yuvalkuck/clearair/hardware/enclosure/sensor_tube.FCStd

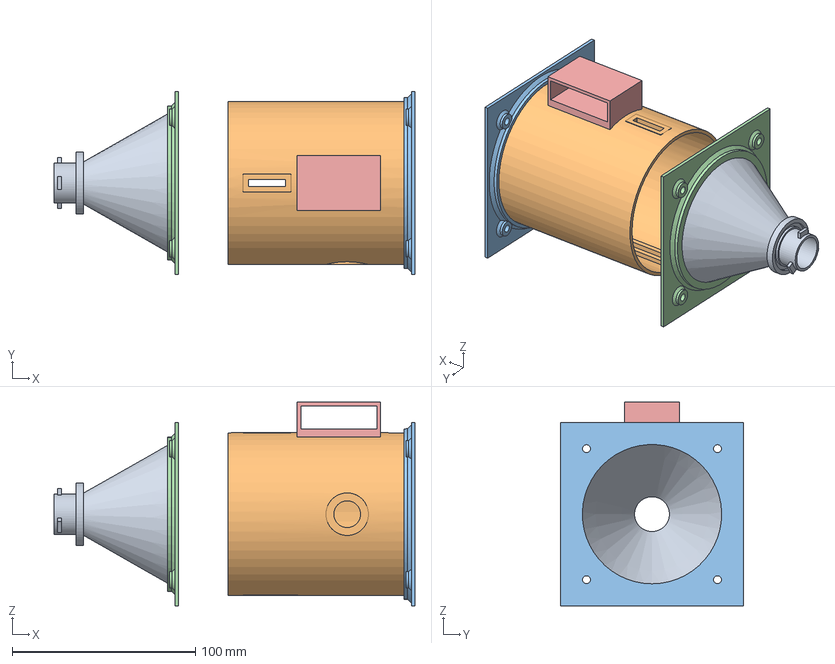
[picture p3: CAD file, 2026-10-23]
hardware/enclosure/sensor_tube.FCStd
197.0 x 100.0 x 111.1 mm
FilterAdapter
SensorTube
FanMount_rear
FanMount_front
SPS30_Holder
