yuvalkuck/clearair/hardware/WeAct-G474CE-Long/clearair.kicad_pcb

## KiCad design hardware/WeAct-G474CE-Long/clearair.kicad_pcb (2026-11-04)

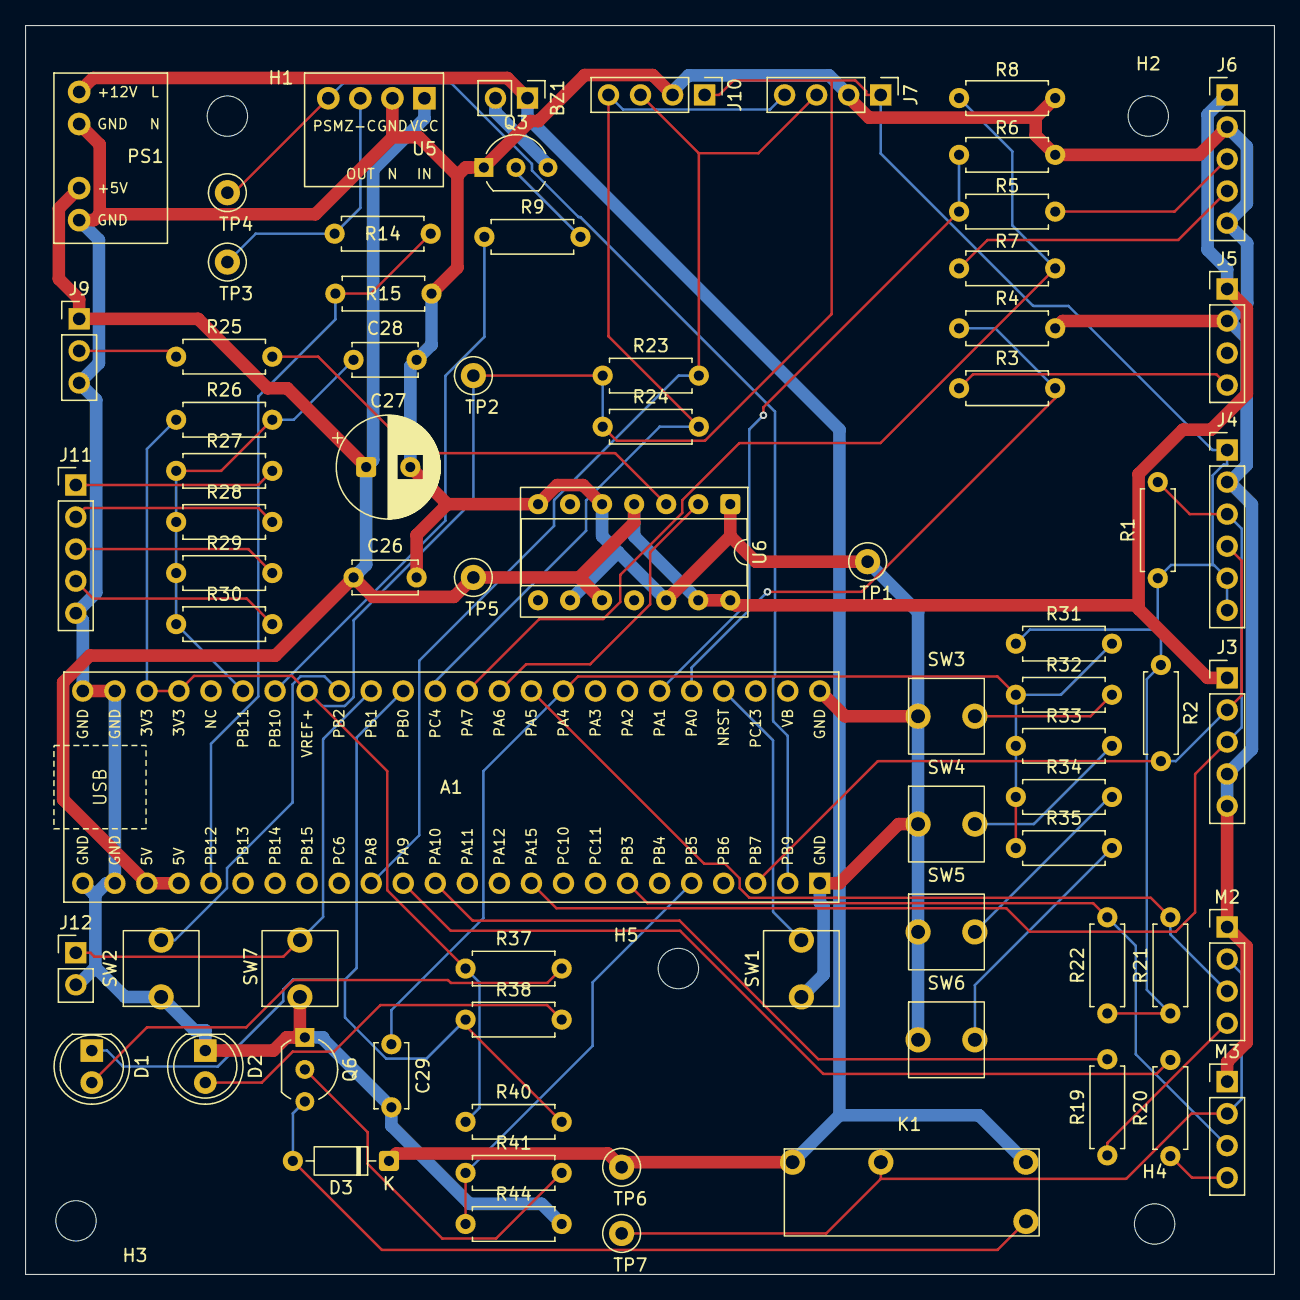
[picture p4: board clearair.kicad_pcb from above]

Board: 2 copper layers, 99.0 x 99.0 mm, 78 parts (0 on the bottom side), 49 nets.

Parts:
A1: WeAct STM32G474CEU6 Core Board (Long); WeAct_STM32G474CoreBoard_Long
BZ1: 12V buzzer; PinHeader_1x02_P2.54mm_Vertical
C26, C28, C29: 100nF; C_Disc_D5.0mm_W2.5mm_P5.00mm
C27: 220uF; CP_Radial_D8.0mm_P3.50mm
D1: GREEN; LED_D5.0mm
D2: RED; LED_D5.0mm
D3: 1N4148; D_DO-35_SOD27_P7.62mm_Horizontal
H1, H2, H3, H4, H5: M3; MountingHole_3.2mm_M3
J3: SPS30; PinHeader_1x05_P2.54mm_Vertical
J4: BME680; PinHeader_1x06_P2.54mm_Vertical
J5: MQ131; PinHeader_1x04_P2.54mm_Vertical
J6: MiCS-4514; PinHeader_1x05_P2.54mm_Vertical
J7: RTC PCF8563; PinHeader_1x04_P2.54mm_Vertical
J9: WS2812B LEDs; PinHeader_1x03_P2.54mm_Vertical
J10: Display I2C2; PinHeader_1x04_P2.54mm_Vertical
J11: Buttons (1-4 KEY1-4, 5 GND); PinHeader_1x05_P2.54mm_Vertical
J12: Standby ext; PinHeader_1x02_P2.54mm_Vertical
K1: ALDP112; Relay_Panasonic_ALDP112
M2: 80mm fan front; PinHeader_1x04_P2.54mm_Vertical
M3: 80mm fan rear; PinHeader_1x04_P2.54mm_Vertical
PS1: AC-DC PSUs 12V 2A + 5V 2A (DC out); PSU_DC_12V_5V_Inputs
Q3, Q6: 2N2222A; TO-92_Inline_Wide
R1, R2, R23, R24: 4k7; R_Axial_DIN0207_L6.3mm_D2.5mm_P7.62mm_Horizontal
R3, R5, R7, R14: 1k8; R_Axial_DIN0207_L6.3mm_D2.5mm_P7.62mm_Horizontal
R4, R6, R8, R15, R28, R33: 3k3; R_Axial_DIN0207_L6.3mm_D2.5mm_P7.62mm_Horizontal
R9, R19, R20, R27, R32, R41: 1k; R_Axial_DIN0207_L6.3mm_D2.5mm_P7.62mm_Horizontal
R21, R22, R26, R31, R44: 10k; R_Axial_DIN0207_L6.3mm_D2.5mm_P7.62mm_Horizontal
R25, R37, R38: 330; R_Axial_DIN0207_L6.3mm_D2.5mm_P7.62mm_Horizontal
R29, R34: 6k8; R_Axial_DIN0207_L6.3mm_D2.5mm_P7.62mm_Horizontal
R30, R35: 15k; R_Axial_DIN0207_L6.3mm_D2.5mm_P7.62mm_Horizontal
R40: 2k2; R_Axial_DIN0207_L6.3mm_D2.5mm_P7.62mm_Horizontal
SW1: RESET red; SW_Tactile_6x6x5_2pin
SW2: COLD_BOOT white; SW_Tactile_6x6x5_2pin
SW3: TEST1; SW_Tactile_6x6x5_2pin
SW4: TEST2; SW_Tactile_6x6x5_2pin
SW5: TEST3; SW_Tactile_6x6x5_2pin
SW6: TEST4; SW_Tactile_6x6x5_2pin
SW7: STANDBY; SW_Tactile_6x6x5_2pin
TP1: GND; TestPoint_Loop_D2.50mm_Drill1.0mm
TP2: +3V3; TestPoint_Loop_D2.50mm_Drill1.0mm
TP3: ZC_OUT; TestPoint_Loop_D2.50mm_Drill1.0mm
TP4: TRIAC_DIMMER; TestPoint_Loop_D2.50mm_Drill1.0mm
TP5: +5V; TestPoint_Loop_D2.50mm_Drill1.0mm
TP6: +12V; TestPoint_Loop_D2.50mm_Drill1.0mm
TP7: FAN_12V; TestPoint_Loop_D2.50mm_Drill1.0mm
U5: RobotDyn AC dimmer; RobotDyn_Dimmer_Logic
U6: 74AHCT125N; DIP-14_W7.62mm_Socket

Connections:
+3V3: A1.37 (VREF+), A1.47 (3V3), A1.48 (3V3), J4.1 (VCC), J4.5 (SDO), J4.6 (CS), J7.1, J10.1, R1.1, R2.1, R21.1, R22.1, R23.1, R24.1, R26.1, R31.1, R37.1, R40.1, TP2.1 (1_1)
+5V: A1.43 (VDD5V), A1.44 (VDD5V), C26.1, C27.1, J3.1, J5.1, J6.1, J9.1, PS1.4, TP5.1 (1_1), U5.1 (VCC), U6.4, U6.10, U6.13, U6.14 (VCC)
+12V: BZ1.1 (+), D3.1 (K), K1.14, K1.A1, PS1.3, TP6.1 (1_1)
/BOOT_MODE: A1.36 (PB2), SW2.2
/BUTTONS_ADC: A1.39 (PB11), C28.1, R26.2, R27.1, R28.1, R29.1, R30.1
/BUZZER_BASE: Q3.2 (B), R9.2
/BUZZER_NEG: BZ1.2 (-), Q3.3 (C)
/BUZZER_ON: A1.38 (PB10), R9.1
/FAN_12V: K1.13, M2.2, M3.2, TP7.1 (1_1)
/FAN_FRONT_PWM: A1.13 (PA10), R19.2
/FAN_FRONT_PWM_IN: M2.4, R19.1
/FAN_FRONT_TACH: A1.30 (PA5), M2.3, R21.2
/FAN_REAR_PWM: A1.14 (PA9), R20.2
/FAN_REAR_PWM_IN: M3.4, R20.1
/FAN_REAR_TACH: A1.7 (PB3), M3.3, R22.2
/FILTER_FAN_POWER: A1.5 (PB5), R41.1, R44.1
/FORCE_STATES_SW: A1.29 (PA4), C29.1, R31.2, R32.1, R33.1, R34.1, R35.1
/I2C_SCL: A1.10 (PA15), J3.3, J4.3 (SCL), R1.2
/I2C_SDA: A1.3 (PB7), J3.2, J4.4 (SDA), R2.2
/LED_DATA: A1.31 (PA6), U6.2
/MICS_CO1: A1.26 (PA1), R5.1, R6.1
/MICS_CO_OUT: J6.3, R5.2
/MICS_NO2: A1.32 (PA7), R7.2, R8.1
/MICS_NO2_OUT: J6.4, R7.1
/MQ131_ADC: A1.25 (PA0), R3.2, R4.1
/MQ131_OUT: J5.4, R3.1
/NRST: A1.24 (NRST), SW1.2
/RTC_SCL: A1.33 (PC4), J7.4, J10.4, R24.2
/RTC_SDA: A1.15 (PA8), J7.3, J10.3, R23.2
/STANDBY_LED: A1.34 (PB0), D1.1 (K), R38.1, R40.2
/STANDBY_SW: A1.35 (PB1), J12.1, SW7.2
/TRIAC_DIMMER: A1.2 (PB9), TP4.1 (1_1), U5.4 (PSM)
/ZC_INPUT: A1.20 (PB12), R14.1, R15.1
/ZC_OUT: R14.2, TP3.1 (1_1), U5.3 (Z-C)
GND: A1.1 (GND), A1.21 (GND), A1.41 (GND), A1.42 (GND), A1.45 (GND), A1.46 (GND), C26.2, C27.2, C28.2, C29.2, D2.1 (K), J3.4, J3.5, J4.2 (GND), J5.2, J6.2, J6.5, J7.2, J9.3, J10.2, J11.5, J12.2, M2.1, M3.1, PS1.5, Q3.1 (E), Q6.1 (E), R4.2, R6.2, R8.2, R15.2, R44.2, SW1.1, SW2.1, SW3.1, SW4.1, SW5.1, SW6.1, SW7.1, TP1.1 (1_1), U5.2 (GND), U6.1, U6.5, U6.7 (GND), U6.9, U6.12
unnamed: D1.2 (A), R37.2
unnamed: D2.2 (A), R38.2
unnamed: D3.2 (A), K1.A2, Q6.3 (C)
unnamed: J9.2, R25.1
unnamed: J11.1, R27.2
unnamed: J11.2, R28.2
unnamed: J11.3, R29.2
unnamed: J11.4, R30.2
unnamed: Q6.2 (B), R41.2
unnamed: R25.2, U6.3
unnamed: R32.2, SW3.2
unnamed: R33.2, SW4.2
unnamed: R34.2, SW5.2
unnamed: R35.2, SW6.2
