yuvalkuck/clearair/Core/Src/main.c

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
/* Includes ------------------------------------------------------------------*/
#include "main.h"
#include "cmsis_os.h"

/* USER CODE BEGIN Includes */
#include <stdio.h>

#include "event_message.h"
#include "queue.h"
/* USER CODE END Includes */

ADC_HandleTypeDef hadc1;
ADC_HandleTypeDef hadc2;
DMA_HandleTypeDef hdma_adc2;

I2C_HandleTypeDef hi2c1;
I2C_HandleTypeDef hi2c2;

TIM_HandleTypeDef htim1;
TIM_HandleTypeDef htim2;
TIM_HandleTypeDef htim3;
TIM_HandleTypeDef htim16;
DMA_HandleTypeDef hdma_tim16_ch1;

UART_HandleTypeDef huart2;

/* Definitions for defaultTask */
osThreadId_t defaultTaskHandle;
const osThreadAttr_t defaultTask_attributes = {
  .name = "defaultTask",
  .priority = (osPriority_t) osPriorityNormal,
  .stack_size = 256 * 4
};
/* Definitions for bmeTask */
osThreadId_t bmeTaskHandle;
const osThreadAttr_t bmeTask_attributes = {
  .name = "bmeTask",
  .priority = (osPriority_t) osPriorityNormal1,
  .stack_size = 512 * 4
};
/* Definitions for msgLoopTask */
osThreadId_t msgLoopTaskHandle;
const osThreadAttr_t msgLoopTask_attributes = {
  .name = "msgLoopTask",
  .priority = (osPriority_t) osPriorityNormal,
  .stack_size = 256 * 4
};
/* Definitions for co1no2Task */
osThreadId_t co1no2TaskHandle;
const osThreadAttr_t co1no2Task_attributes = {
  .name = "co1no2Task",
  .priority = (osPriority_t) osPriorityNormal1,
  .stack_size = 256 * 4
};
/* Definitions for particleTask */
osThreadId_t particleTaskHandle;
const osThreadAttr_t particleTask_attributes = {
  .name = "particleTask",
  .priority = (osPriority_t) osPriorityNormal,
  .stack_size = 512 * 4
};
/* Definitions for o3Task */
osThreadId_t o3TaskHandle;
const osThreadAttr_t o3Task_attributes = {
  .name = "o3Task",
  .priority = (osPriority_t) osPriorityNormal,
  .stack_size = 512 * 4
};
/* Definitions for rtcTask */
osThreadId_t rtcTaskHandle;
const osThreadAttr_t rtcTask_attributes = {
  .name = "rtcTask",
  .priority = (osPriority_t) osPriorityLow,
  .stack_size = 256 * 4
};
/* Definitions for SensorEvents */
osMessageQueueId_t SensorEventsHandle;
const osMessageQueueAttr_t SensorEvents_attributes = {
  .name = "SensorEvents"
};
/* USER CODE BEGIN PV */
extern QueueHandle_t sensorsQueue;
/* USER CODE END PV */

void SystemClock_Config(void);
static void MX_GPIO_Init(void);
static void MX_DMA_Init(void);
static void MX_ADC1_Init(void);
static void MX_ADC2_Init(void);
static void MX_I2C1_Init(void);
static void MX_TIM3_Init(void);
static void MX_USART2_UART_Init(void);
static void MX_TIM1_Init(void);
static void MX_TIM2_Init(void);
static void MX_I2C2_Init(void);
static void MX_TIM16_Init(void);
void StartDefaultTask(void *argument);
extern void bmeTaskHandler(void *argument);
extern void mainSensorsMsgLoop(void *argument);
extern void co1no2TaskHandler(void *argument);
extern void particleTaskHandler(void *argument);
extern void o3TaskHandler(void *argument);
extern void rtcTaskHandler(void *argument);

/* USER CODE BEGIN PFP */
extern void appStartDefaultTask(void *argument);

#ifdef __GNUC__
#define PUTCHAR_PROTOTYPE int __io_putchar(int ch)
#else
#define PUTCHAR_PROTOTYPE int fputc(int ch, FILE *f)
#endif

PUTCHAR_PROTOTYPE
{
  // Replace huart1 with your actual UART instance (e.g., huart2 or huart3)
  HAL_UART_Transmit(&huart2, (uint8_t *)&ch, 1, HAL_MAX_DELAY);
  return ch;
}
/* USER CODE END PFP */

/**
  * @brief  The application entry point.
  * @retval int
  */
int main(void)
{

  /* USER CODE BEGIN 1 */
  SystemInit();
  /* USER CODE END 1 */

  /* MCU Configuration--------------------------------------------------------*/

  /* Reset of all peripherals, Initializes the Flash interface and the Systick. */
  HAL_Init();

  /* Configure the system clock */
  SystemClock_Config();

  /* Initialize all configured peripherals */
  MX_GPIO_Init();
  MX_DMA_Init();
  MX_ADC1_Init();
  MX_ADC2_Init();
  MX_I2C1_Init();
  MX_TIM3_Init();
  MX_USART2_UART_Init();
  MX_TIM1_Init();
  MX_TIM2_Init();
  MX_I2C2_Init();
  MX_TIM16_Init();
  /* Init scheduler */
  osKernelInitialize();

  /* USER CODE BEGIN RTOS_MUTEX */
  /* add mutexes, ... */
  /* USER CODE END RTOS_MUTEX */

  /* USER CODE BEGIN RTOS_SEMAPHORES */
  /* add semaphores, ... */
  /* USER CODE END RTOS_SEMAPHORES */

  /* USER CODE BEGIN RTOS_TIMERS */
  /* start timers, add new ones, ... */
  /* USER CODE END RTOS_TIMERS */

  /* Create the queue(s) */
  /* creation of SensorEvents */
  SensorEventsHandle = osMessageQueueNew (42, sizeof(struct CommonMessage), &SensorEvents_attributes);

  /* USER CODE BEGIN RTOS_QUEUES */
  /* add queues, ... */
  /* USER CODE END RTOS_QUEUES */

  /* Create the thread(s) */
  /* creation of defaultTask */
  defaultTaskHandle = osThreadNew(StartDefaultTask, NULL, &defaultTask_attributes);

  /* creation of bmeTask */
  bmeTaskHandle = osThreadNew(bmeTaskHandler, NULL, &bmeTask_attributes);

  /* creation of msgLoopTask */
  msgLoopTaskHandle = osThreadNew(mainSensorsMsgLoop, NULL, &msgLoopTask_attributes);

  /* creation of co1no2Task */
  co1no2TaskHandle = osThreadNew(co1no2TaskHandler, NULL, &co1no2Task_attributes);

  /* creation of particleTask */
  particleTaskHandle = osThreadNew(particleTaskHandler, NULL, &particleTask_attributes);

  /* creation of o3Task */
  o3TaskHandle = osThreadNew(o3TaskHandler, NULL, &o3Task_attributes);

  /* creation of rtcTask */
  rtcTaskHandle = osThreadNew(rtcTaskHandler, NULL, &rtcTask_attributes);

  /* USER CODE BEGIN RTOS_THREADS */
  /* add threads, ... */
  /* USER CODE END RTOS_THREADS */

  /* USER CODE BEGIN RTOS_EVENTS */
  /* add events, ... */
  /* USER CODE END RTOS_EVENTS */

  /* Start scheduler */
  osKernelStart();

  /* We should never get here as control is now taken by the scheduler */

  /* Infinite loop */
  /* USER CODE BEGIN WHILE */
  while (1)
  {

    /* USER CODE END WHILE */

    /* USER CODE BEGIN 3 */
  }
  /* USER CODE END 3 */
}

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
/* USER CODE BEGIN Header_StartDefaultTask */
/**
  * @brief  Function implementing the defaultTask thread.
  * @param  argument: Not used
  * @retval None
  */
/* USER CODE END Header_StartDefaultTask */
void StartDefaultTask(void *argument)
{
  /* USER CODE BEGIN 5 */
  appStartDefaultTask(argument);
  /* Infinite loop */
  for(;;)
  {
    osDelay(1);
  }
  /* USER CODE END 5 */
}

/**
  * @brief  Period elapsed callback in non blocking mode
  * @note   This function is called  when TIM6 interrupt took place, inside
  * HAL_TIM_IRQHandler(). It makes a direct call to HAL_IncTick() to increment
  * a global variable "uwTick" used as application time base.
  * @param  htim : TIM handle
  * @retval None
  */
void HAL_TIM_PeriodElapsedCallback(TIM_HandleTypeDef *htim)
{
  if (htim->Instance == TIM6)
  {
    HAL_IncTick();
  }
}

/**
  * @brief  This function is executed in case of error occurrence.
  * @retval None
  */
void Error_Handler(void)
{
  /* USER CODE BEGIN Error_Handler_Debug */
  /* User can add his own implementation to report the HAL error return state */
  __disable_irq();
  while (1)
  {
  }
  /* USER CODE END Error_Handler_Debug */
}
#ifdef USE_FULL_ASSERT
/**
  * @brief  Reports the name of the source file and the source line number
  *         where the assert_param error has occurred.
  * @param  file: pointer to the source file name
  * @param  line: assert_param error line source number
  * @retval None
  */
void assert_failed(uint8_t *file, uint32_t line)
{
  /* USER CODE BEGIN 6 */
  /* User can add his own implementation to report the file name and line number,
     ex: printf("Wrong parameters value: file %s on line %d\r\n", file, line) */
  /* USER CODE END 6 */
}
#endif /* USE_FULL_ASSERT */
