yuvalkuck/clearair/clear-air.ioc

Mcu.UserName=STM32G474CEUx
PA0.GPIO_Label=MQ131_ADC
PA0.Signal=ADC1_IN1
PA1.GPIO_Label=MICS_CO1
PA1.Signal=ADC2_IN2
PA10.GPIO_Label=FAN_FRONT_PWM
PA10.Signal=S_TIM1_CH3
PA13.Signal=SYS_JTMS-SWDIO
PA14.Signal=SYS_JTCK-SWCLK
PA15.GPIO_Label=I2C_SCL
PA15.Signal=I2C1_SCL
PA2.Signal=USART2_TX
PA3.Signal=USART2_RX
PA4.GPIO_Label=FORCE_STATES_SW
PA4.Signal=ADC2_IN17
PA5.GPIO_Label=FAN_FRONT_TACH
PA5.Signal=S_TIM2_CH1
PA6.GPIO_Label=LED_DATA
PA6.Signal=S_TIM16_CH1
PA7.GPIO_Label=MICS_NO2
PA7.Signal=ADC2_IN4
PA8.GPIO_Label=RTC_SDA
PA8.Signal=I2C2_SDA
PA9.GPIO_Label=FAN_REAR_PWM
PA9.Signal=S_TIM1_CH2
PB0.GPIO_Label=STANDBY_LED
PB0.Signal=GPIO_Output
PB1.GPIO_Label=STANDBY_SW
PB1.Signal=GPIO_Input
PB10.GPIO_Label=BUZZER_ON
PB10.Signal=GPIO_Output
PB11.GPIO_Label=BUTTONS_ADC
PB11.Signal=ADC2_IN14
PB12.GPIO_Label=ZC_INPUT
PB12.Signal=GPXTI12
PB2.GPIO_Label=BOOT_MODE
PB2.Signal=GPIO_Input
PB3.GPIO_Label=FAN_REAR_TACH
PB3.Signal=S_TIM2_CH2
PB5.GPIO_Label=FILTER_FAN_POWER
PB5.Signal=GPIO_Output
PB7.GPIO_Label=I2C_SDA
PB7.Signal=I2C1_SDA
PB9.GPIO_Label=TRIAC_DIMMER
PB9.Signal=GPIO_Output
PC4.GPIO_Label=RTC_SCL
PC4.Signal=I2C2_SCL
PC6.GPIO_Label=LED_BOARD
PC6.Signal=GPIO_Output
PF0-OSC_IN.Signal=RCC_OSC_IN
PF1-OSC_OUT.Signal=RCC_OSC_OUT
