yuvalkuck/clearair/Core/Inc/main.h

#define MQ131_ADC_Pin GPIO_PIN_0
#define MQ131_ADC_GPIO_Port GPIOA
#define MICS_CO1_Pin GPIO_PIN_1
#define MICS_CO1_GPIO_Port GPIOA
#define FORCE_STATES_SW_Pin GPIO_PIN_4
#define FORCE_STATES_SW_GPIO_Port GPIOA
#define FAN_FRONT_TACH_Pin GPIO_PIN_5
#define FAN_FRONT_TACH_GPIO_Port GPIOA
#define LED_DATA_Pin GPIO_PIN_6
#define LED_DATA_GPIO_Port GPIOA
#define MICS_NO2_Pin GPIO_PIN_7
#define MICS_NO2_GPIO_Port GPIOA
#define RTC_SCL_Pin GPIO_PIN_4
#define RTC_SCL_GPIO_Port GPIOC
#define STANDBY_LED_Pin GPIO_PIN_0
#define STANDBY_LED_GPIO_Port GPIOB
#define STANDBY_SW_Pin GPIO_PIN_1
#define STANDBY_SW_GPIO_Port GPIOB
#define BOOT_MODE_Pin GPIO_PIN_2
#define BOOT_MODE_GPIO_Port GPIOB
#define BUZZER_ON_Pin GPIO_PIN_10
#define BUZZER_ON_GPIO_Port GPIOB
#define BUTTONS_ADC_Pin GPIO_PIN_11
#define BUTTONS_ADC_GPIO_Port GPIOB
#define ZC_INPUT_Pin GPIO_PIN_12
#define ZC_INPUT_GPIO_Port GPIOB
#define ZC_INPUT_EXTI_IRQn EXTI15_10_IRQn
#define LED_BOARD_Pin GPIO_PIN_6
#define LED_BOARD_GPIO_Port GPIOC
#define RTC_SDA_Pin GPIO_PIN_8
#define RTC_SDA_GPIO_Port GPIOA
#define FAN_REAR_PWM_Pin GPIO_PIN_9
#define FAN_REAR_PWM_GPIO_Port GPIOA
#define FAN_FRONT_PWM_Pin GPIO_PIN_10
#define FAN_FRONT_PWM_GPIO_Port GPIOA
#define I2C_SCL_Pin GPIO_PIN_15
#define I2C_SCL_GPIO_Port GPIOA
#define FAN_REAR_TACH_Pin GPIO_PIN_3
#define FAN_REAR_TACH_GPIO_Port GPIOB
#define FILTER_FAN_POWER_Pin GPIO_PIN_5
#define FILTER_FAN_POWER_GPIO_Port GPIOB
#define I2C_SDA_Pin GPIO_PIN_7
#define I2C_SDA_GPIO_Port GPIOB
#define TRIAC_DIMMER_Pin GPIO_PIN_9
#define TRIAC_DIMMER_GPIO_Port GPIOB
#define DETECTION_SLEEP_LOOP_LIMIT 50000 // 5sec of sleep
