yuvalkuck/clearair/Core/Inc/cpp_main.h

//
// Created by uv on 20/07/2026.
//

#ifndef CLEARAIR_CPP_MAIN_H
#define CLEARAIR_CPP_MAIN_H

#ifdef __cplusplus
#include "event_message.h"
extern "C" {
#endif
#include "main.h"

#ifdef __cplusplus
}
#endif


#endif //CLEARAIR_CPP_MAIN_H
