yuvalkuck/clearair/Core/Inc/app_main.h

//
// Created by uv on 20/07/2026.
//

#ifndef CLEARAIR_APP_MAIN_H
#define CLEARAIR_APP_MAIN_H

#ifdef __cplusplus
#include "event_message.h"
extern "C" {
#endif
#include "main.h"
int app_main(void);
#ifdef __cplusplus
}
#endif


#endif //CLEARAIR_APP_MAIN_H
