yuvalkuck/clearair/app/bme68x/src/task_bme680.cpp

//
// Created by uv on 22/07/2026.
//

#include "stm32f4xx.h"
#include "bridge_bme680.h"
#include "task_bme680.h"
#include "cmsis_os.h"
#include "bme68x.h"
#include "bsec_interface.h"
#include "bsec_iaq.h"
#include "event_message.h"
#include "queue.h"
extern osThreadId_t bmeSensorTaskHandle;
static uint8_t work_buffer[BSEC_MAX_WORKBUFFER_SIZE];
static bme68x_dev commBridgeCfg = {0};
static constexpr uint32_t BSEC_TASK_MAX_WAIT_MS     = 2000; // BME68x max heater dur
#define BSEC_REQUESTED_OUTPUTS 6

static auto applyBsecSensorSettings(const bsec_bme_settings_t& settings) {
    bme68x_conf conf{};
    bme68x_heatr_conf heatr_conf{};

    auto rc = bme68x_get_conf(&conf, &commBridgeCfg);
    if (rc != BME68X_OK) { return rc; }

    conf.os_hum = settings.humidity_oversampling;
    conf.os_temp = settings.temperature_oversampling;
    conf.os_pres = settings.pressure_oversampling;
    rc = bme68x_set_conf(&conf, &commBridgeCfg);
    if (rc != BME68X_OK) { return rc; }

    heatr_conf.enable = BME68X_ENABLE;
    heatr_conf.heatr_temp = settings.heater_temperature;
    heatr_conf.heatr_dur = settings.heater_duration;
    rc = bme68x_set_heatr_conf(BME68X_FORCED_MODE, &heatr_conf, &commBridgeCfg);
    if (rc != BME68X_OK) { return rc; }

    rc = bme68x_set_op_mode(BME68X_FORCED_MODE, &commBridgeCfg);
    return rc;
}
void TaskBme680::run() {
    osThreadResume(bmeSensorTaskHandle);
}

bool TaskBme680::configure(osMessageQueueId_t output_queue, I2C_HandleTypeDef* hi2c, uint8_t i2c_addr8) {
    msgQueue_ = (QueueHandle_t)output_queue;
    auto rc = initBridgeBME68x(hi2c, commBridgeCfg, i2c_addr8);
    if (rc != BME68X_OK) {
        return false;
    }
    rc = bsec_init();
    if (rc != BSEC_OK) {
        return false;
    }

    rc = bsec_set_configuration(bsec_config_iaq, sizeof(bsec_config_iaq),
                                work_buffer, sizeof(work_buffer));
    if (rc != BSEC_OK) {
        return false;
    }

    bsec_sensor_configuration_t requestedOutputs[BSEC_REQUESTED_OUTPUTS];
    uint8_t nRequested = 0;

    requestedOutputs[nRequested++] = {BSEC_SAMPLE_RATE_LP, BSEC_OUTPUT_IAQ};
    requestedOutputs[nRequested++] = {BSEC_SAMPLE_RATE_LP, BSEC_OUTPUT_STATIC_IAQ};
    requestedOutputs[nRequested++] = {BSEC_SAMPLE_RATE_LP, BSEC_OUTPUT_CO2_EQUIVALENT};
    requestedOutputs[nRequested++] = {BSEC_SAMPLE_RATE_LP, BSEC_OUTPUT_BREATH_VOC_EQUIVALENT};
    requestedOutputs[nRequested++] = {BSEC_SAMPLE_RATE_LP, BSEC_OUTPUT_RAW_TEMPERATURE};
    requestedOutputs[nRequested++] = {BSEC_SAMPLE_RATE_LP, BSEC_OUTPUT_RAW_HUMIDITY};

    bsec_sensor_configuration_t requiredSensorSettings[BSEC_MAX_PHYSICAL_SENSOR];
    uint8_t nRequired = BSEC_MAX_PHYSICAL_SENSOR;

    rc = bsec_update_subscription(requestedOutputs, nRequested,
                                  requiredSensorSettings, &nRequired);

    return (rc == BSEC_OK);
}

static uint32_t getTimestampMs() {
    // Convert ticks to milliseconds safely based on your RTOS clock rate
    // (If configTICK_RATE_HZ is 1000, ms directly equals ticks)
    return osKernelGetTickCount() * 1000 / osKernelGetTickFreq();
}

static int64_t getTimestampNs() {
    // Convert milliseconds to nanoseconds
    return 1000000ULL * getTimestampMs();
}

void TaskBme680::readAndSendToQueue(const bsec_bme_settings_t& s, int64_t timestamp_ns) {
    bme68x_data data;
    uint8_t n_data = 0;
    if (bme68x_get_data(BME68X_FORCED_MODE, &data, &n_data, &commBridgeCfg) != BME68X_OK || n_data == 0)
        return;

    bsec_input_t inputs[BSEC_MAX_PHYSICAL_SENSOR];
    uint8_t n_inputs = 0;

    if (s.process_data & BSEC_PROCESS_TEMPERATURE) {
        inputs[n_inputs].sensor_id = BSEC_INPUT_TEMPERATURE;
        inputs[n_inputs].signal = data.temperature;
        inputs[n_inputs].time_stamp = timestamp_ns;
        n_inputs++;
    }
    if (s.process_data & BSEC_PROCESS_HUMIDITY) {
        inputs[n_inputs].sensor_id = BSEC_INPUT_HUMIDITY;
        inputs[n_inputs].signal = data.humidity;
        inputs[n_inputs].time_stamp = timestamp_ns;
        n_inputs++;
    }
    if (s.process_data & BSEC_PROCESS_PRESSURE) {
        inputs[n_inputs].sensor_id = BSEC_INPUT_PRESSURE;
        inputs[n_inputs].signal = data.pressure;
        inputs[n_inputs].time_stamp = timestamp_ns;
        n_inputs++;
    }
    if (s.process_data & BSEC_PROCESS_GAS) {
        inputs[n_inputs].sensor_id = BSEC_INPUT_GASRESISTOR;
        inputs[n_inputs].signal = data.gas_resistance;
        inputs[n_inputs].time_stamp = timestamp_ns;
        n_inputs++;
    }

    bsec_output_t outputs[BSEC_NUMBER_OUTPUTS];
    uint8_t n_outputs = BSEC_NUMBER_OUTPUTS;
    if (n_inputs == 0) return;
    if (bsec_do_steps(inputs, n_inputs, outputs, &n_outputs) != BSEC_OK) return;

    CommonMessage msg{};
    msg.id = BME680;
    msg.timestamp_ms = getTimestampMs();
    auto& payload = msg.payload.bme680;

    for (uint8_t i = 0; i < n_outputs; i++) {
        payload.type = NO_VALUE;
        payload.value = outputs[i].signal;
        switch (outputs[i].sensor_id) {
            case BSEC_OUTPUT_IAQ:
                payload.type = IAQ;
                payload.accuracy = outputs[i].accuracy;
                break;
            case BSEC_OUTPUT_STATIC_IAQ:
                payload.type = STATIC_IAQ;
                break;
            case BSEC_OUTPUT_CO2_EQUIVALENT:
                payload.type = CO2_EQUIVALENT;
                break;
            case BSEC_OUTPUT_BREATH_VOC_EQUIVALENT:
                payload.type = VOC_EQUIVALENT;
                break;
            case BSEC_OUTPUT_SENSOR_HEAT_COMPENSATED_TEMPERATURE:
                payload.type = TEMPERATURE;
                break;
            case BSEC_OUTPUT_SENSOR_HEAT_COMPENSATED_HUMIDITY:
                payload.type = HUMIDITY;
                break;
            case BSEC_OUTPUT_RAW_PRESSURE:
                payload.type = PRESSURE;
                break;
            case BSEC_OUTPUT_RAW_GAS:
                payload.type = VOC_EQUIVALENT;
                break;
            case BSEC_OUTPUT_STABILIZATION_STATUS:
            case BSEC_OUTPUT_RUN_IN_STATUS:
            default:
                break;
        }
        if (payload.type != NO_VALUE) {
            // Never block indefinitely: system is never low power, task must keep BSEC cadence
            xQueueSend(msgQueue_, &msg, pdMS_TO_TICKS(5));
        }
    }
}

void TaskBme680::taskLoop() {
    for (;;) {
        int64_t timestamp_ns = getTimestampNs();

        bsec_bme_settings_t bme_settings;
        bsec_sensor_control(timestamp_ns, &bme_settings);

        if (bme_settings.trigger_measurement) {
            applyBsecSensorSettings(bme_settings);

            uint32_t wait_ms = 10;
            if (bme_settings.run_gas && bme_settings.heater_duration > 0) {
                wait_ms = (uint32_t)bme_settings.heater_duration + 10;
                if (wait_ms > BSEC_TASK_MAX_WAIT_MS)   // critical fix #2: hard cap
                    wait_ms = BSEC_TASK_MAX_WAIT_MS;
            }
            vTaskDelay(pdMS_TO_TICKS(wait_ms));

            readAndSendToQueue(bme_settings, timestamp_ns);
        }

        int64_t next_call_ns = bme_settings.next_call - timestamp_ns;
        uint32_t delay_ms = (next_call_ns > 0) ? (uint32_t)(next_call_ns / 1000000) : 1;
        vTaskDelay(pdMS_TO_TICKS(delay_ms));
    }
}
