yuvalkuck/clearair/device/particle/src/task_particle.cpp

// //
// // Created by uv on 22/07/2026.
// //
//
#include "stm32g4xx.h"
#include "task_particle.h"
#include "sensirion_common.h"
#include "bridge_particle.h"
#include "sps30_i2c.h"
#include "sensirion_i2c_hal.h"
#include "timestamp.h"
#include "event_message.h"
#include "logger.h"

bool SensorParticle::configure(I2C_HandleTypeDef* hi2c) {
    METHODTRACE
    initBridgeParticle(hi2c, SPS30_I2C_ADDR_69);
    sps30_init(SPS30_I2C_ADDR_69);
    auto rc = sps30_stop_measurement();
    if ( rc != NO_ERROR) {
        METHODLOG(fatal, "sps30_stop_measurement failed")
    }
#if defined(DEBUG)
    int8_t serial_number[32] = {0};
    int8_t product_type[8] = {0};
    rc = sps30_read_serial_number(serial_number, sizeof(serial_number));
    METHODLOGS(trace, "sps30_read_serial_number(): %p", serial_number);
    rc = sps30_read_product_type(product_type, sizeof(product_type));
    METHODLOGS(trace, "product_type: %p", product_type);
#endif
    return (rc == 0);
}

constexpr auto PARTICLE_CYCLE_TIME_MS = 60 * 1000;
constexpr auto PARTICLE_ONERROR_CYCLE_MS = 10 * 1000;
static CommonMessage msg{};
void SensorParticle::taskLoop() {
    METHODTRACE
    msg.id = SPS30Particle;
    auto& payload = msg.payload.particle;

    auto rc = sps30_start_measurement(SPS30_OUTPUT_FORMAT_OUTPUT_FORMAT_FLOAT);
    if (rc != NO_ERROR) {
        METHODLOG(fatal, "sps30_start_measurement failed")
        for (;;) {
            vTaskDelay(portMAX_DELAY); // a task must never return: park it
        }
    }
    sensirion_i2c_hal_sleep_usec(10000);
    uint16_t data_ready_flag = 0;
    float unusedRead[7];
    for (;;) {
        auto startTM = getTimestampMs();
        rc = sps30_read_data_ready_flag(&data_ready_flag);
        if (rc != 0) {
            printf("error executing read_data_ready_flag(): %i\n", rc);
            vTaskDelay(pdMS_TO_TICKS(PARTICLE_ONERROR_CYCLE_MS));
            continue;
        }

        rc = sps30_read_measurement_values_float(&unusedRead[0], &payload.mc_2p5,
                                                 &unusedRead[1], &payload.mc_10p0,
                                                 &unusedRead[2], &unusedRead[3],
                                                 &unusedRead[4], &unusedRead[5],
                                                 &unusedRead[6],&payload.tps);
        if (rc != 0) {
            printf("error executing read_measurement_values_float(): %i\n",
                   rc);
            vTaskDelay(pdMS_TO_TICKS(PARTICLE_ONERROR_CYCLE_MS));
            continue;
        }
        msg.timestamp_ms = getTimestampMs();
        xQueueSend(msgQueue_, &msg, pdMS_TO_TICKS(5));
        boundedDelay(getTimestampMs() - startTM);
    }
}
