yuvalkuck/clearair/device/bme68x/inc/task_bme680.h

//
// Created by uv on 22/07/2026.
//

#ifndef CLEARAIR_TASK_BME680_H
#define CLEARAIR_TASK_BME680_H
#include "cmsis_os.h"
#include "stm32g4xx_hal_i2c.h"
#include "bme68x_defs.h"
#include "bsec_datatypes.h"
#include "FreeRTOS.h"
#include "queue.h"
#include "base_device_task.h"
/**
 * the class use the BSEC lib, so get new data will invoke the run() method every X seconds
 * and if there is a new data the lib will asynchronicity send back to the message queue.
 * " Calling .run(), If the internal sampling interval X seconds has not elapsed,
 * .run() does nothing and exits immediately."
 */
class SensorBme68x : public BaseDeviceTask {
    void readAndSendToQueue(const bsec_bme_settings_t& s, int64_t timestamp_ns);
public:
    SensorBme68x() = default;

    bool configure(
        I2C_HandleTypeDef* hi2c
    );
    [[noreturn]] void taskLoop();


};
#endif //CLEARAIR_TASK_BME680_H
