yuvalkuck/clearair/(commit log)

2026-06-21 Initial STM32 project commit
2026-07-28 add handled to Bme680+BSEC2 & add tasks for message loop.
    [bsec_iaq.csv]
2026-08-02 working MQ7 CO1 sensor
2026-08-04 working particles sensor with all the others.
2026-08-04 change sensors list
2026-08-05 upgrade HLD according to change in sensors
2026-08-08 remove RTT, use common printf to terminal
2026-08-10 replace PA6/10 + TIM2 with PC6/7 + TIM3 becase of possible pin burn.
    [clearair.ioc, main.c, main.h]
2026-08-29 add logger.h - save, sensors & board fryied :(
2026-09-01 replace fried i2c1,2 to i2c3
    [bridge_particle.cpp, clearair.ioc, cpp_main.cpp, main.c, task_bme680.cpp, task_particle.cpp]
2026-09-03 make MQ131 run ans solved race condition with tasks & scheduler
    [clearair.ioc, cpp_main.cpp, main.c, task_bme680.cpp, task_mics4514.cpp, task_mq131.cpp]
2026-09-05 create the functionality for AC_DIMMER but it does not work,yet.
    [clearair.ioc, cpp_main.cpp, main.c, main.h, task_fanctrl.cpp, task_fanctrl.h]
2026-09-10 fix delay in log.
    [cpp_main.cpp]
2026-10-16 add kicad schema
2026-10-16 update md with power consamption estimation
2026-10-18 add schematic of new G4 board
2026-10-18 ignore kicad and other temp files
2026-10-21 finalize g4 move, add control_center.cpp and add more fans, start desing of Enclosure.
2026-10-26 try to make a pcb with 3D printer but the printer is dead.
2026-10-27 fix script generators to not need external json files, source is now PCB and SCH
2026-10-29 crate a wire buses for power
2026-10-29 add optional wires
2026-10-30 add wire colors (8)
2026-10-30 make kicad standard, make wire_list.py a generic script
2026-10-30 finalize kicad standards
2026-10-31 fix claude messing with the sort of wires, again.
2026-11-09 add UT framework
